jcangeles/ENGR301/README.md

# ENGR301  

SFSU - ENGR 301 Microelectronics Lab  

Final Project - Low Noise Headphone Amplifier  

See final report for documentation.  

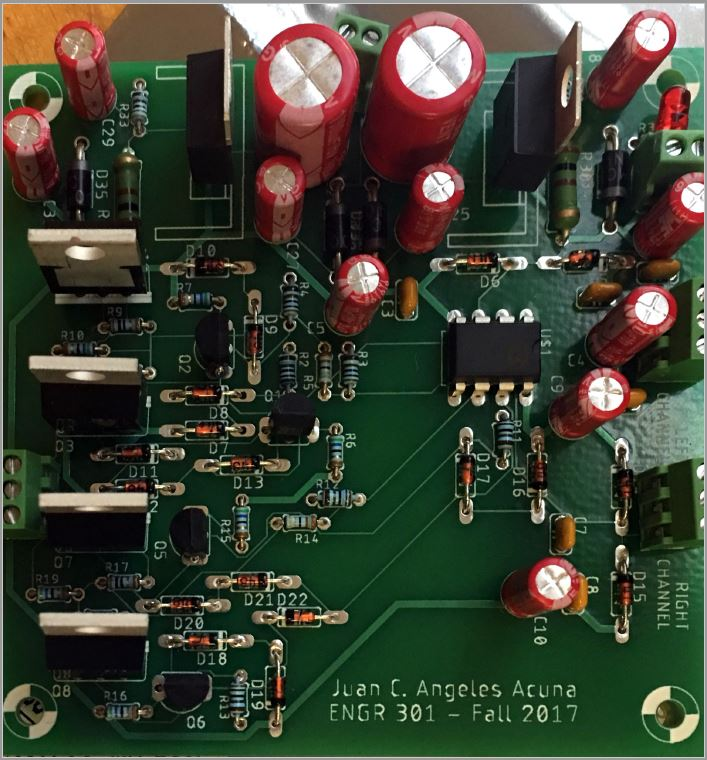
[picture p1: final board.JPG]
"Spirit Machine Wire Diagram"
