jcangeles/ENGR301/Final Report.pdf

Final Project Report

ENGR 301
Section 1
Fall, 2017

Juan C. Angeles Acuna
Jasmine Lai
12/10/17

Electrical Engineering
Engineering Department
San Francisco State University

Objective:
This report details the building process of our Engr 301 final project, a low-noise headphone amplifier. The objective of the project was to familiarize students with the process of designing and building a circuit, its board, component assembly, and testing/debugging our board

Components List:
Students were challenged to minimize the total price of components purchased. We were able to price the total price per board below ~$30 by buying in bulk as a group. Our Bill of Materials is listed in Appendix A at the end of this report.

Design:
Amplifier: A low-noise amplifier or LNA is an electronic amplifier that amplifies a very low-power signal without significantly degrading its signal-to-noise ration and minimize any additional noise. Our design for the amplifier (show below) is composed of four primary parts.

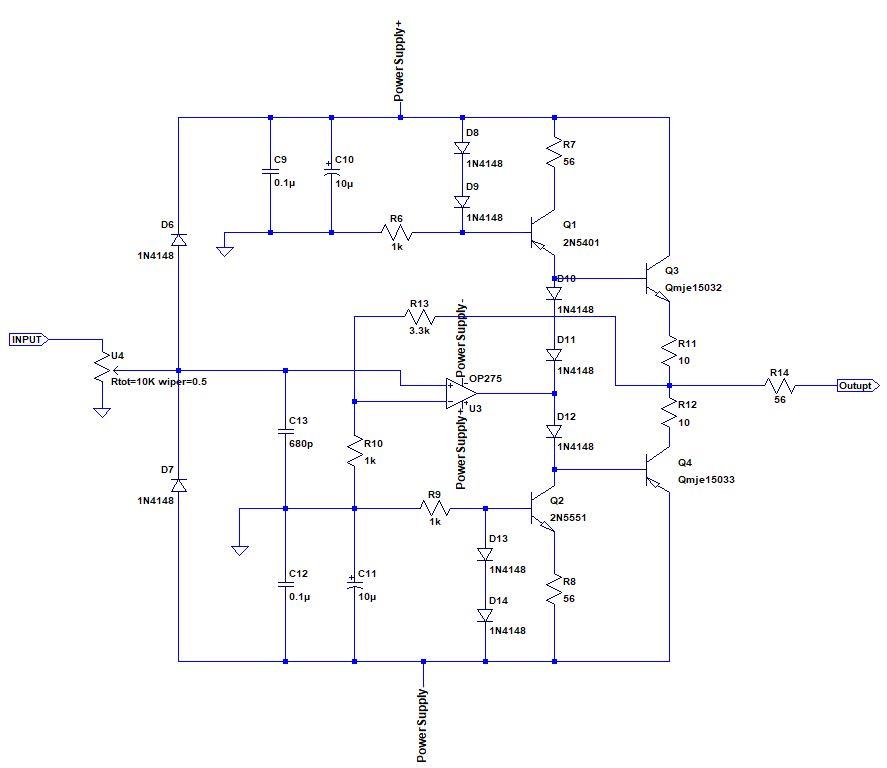
[picture p2: figure]

Amplifier simulation recreated in LTSpice

### 1. Non-Inverting Amplifier (OP275)

In the amplifier design, the non-inverting amplifier played a major role in keeping the distortion rate in the low range. It is known to be a highly valued op amp that can generally output linearly waveforms. Since non-inverting amplifiers are very sensitive compared to other op amps, they
would be able to reproduce the most accurate waveforms. More importantly, it combines both

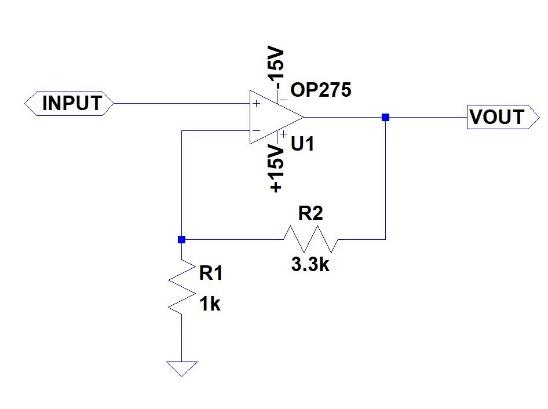
[picture p3: figure]

bipolar and other transistors to help maintain the speed and sound quality, making it the perfect op amp to use for the amplifier design

### 2. Voltage Divider (Potentiometer)

The voltage divider is a common engineering tool generally used in a variety of industries. Used as a voltage divider for various circuits, it’s main structure consists of three terminals total, where two of these terminals are connected to the ends of a resistive component. This type of resistive component is usually regarded as two resistors connected in series whereas the wiper determines the resistance ratio of the first resistor to the second resistor. Most importantly, it provides a changeable voltage as a control level in the amplifier circuit design in the final project.

### 3. Output Voltage Swing (Transistors)

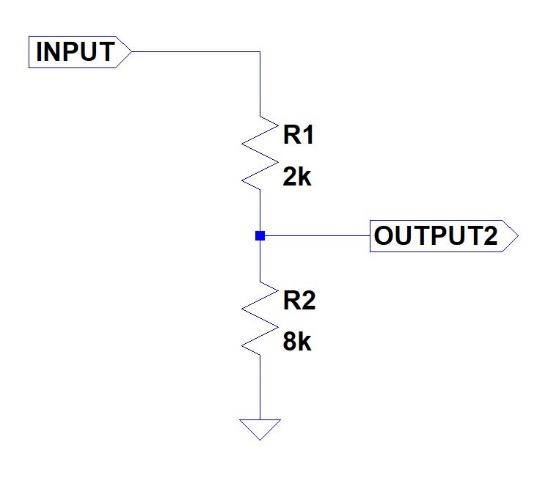
[picture p4: figure]

The output voltage swings are a set of transistors, which are defined as how close the op-amp output is under specified conditions. The main goal of these transistors is to determine the amount of current of the op-amp and its capability of the op-amp is largely dependent on the op-amp’s output along with the load current. The transistors played a critical role to the amplifier circuit design as they tell you whether the circuit works as planned.

### 4. Filter Capacitors

The filter capacitors play a role of filtering out a certain range of different frequencies in a circuit board. Acting as a low-pass filter, these capacitors are in charge of passing through low frequency signals and blocking the high frequency signals. Their purpose is not to filter noise that’s coming in, but to prevent any device from injecting noise into the main section.

Power supply: Our power supply is composed of a rectifier circuit that acts as a AC to DC converter, and we regulate the output voltage to +15 and -15V. The PSU, pictured below, is composed of 4 main sections.

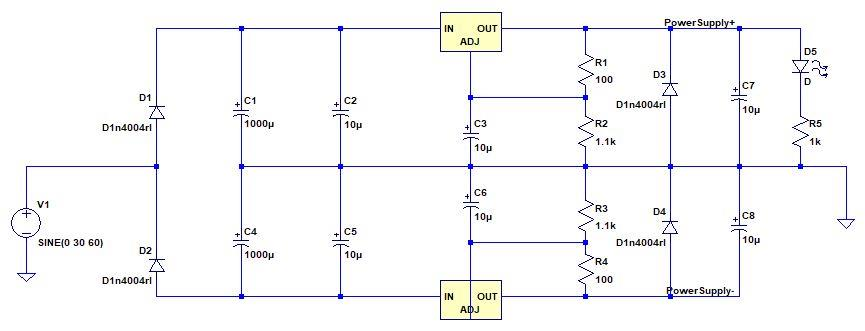
[picture p5: figure]

PSU in LTSpice Simulation

### 1. Rectifier (Diode)

In the power supply design, the rectifier is an electrical device that converts alternating current(AC) to direct current(DC). It is composed of one or more diodes and it can take the shape of various forms. Most importantly, the rectifier can be performed in a variety of such as a source of power used in laptops, televisions, and video games. Based on the power supply design, we needed a rectifier
to get DC current to operate the circuit.

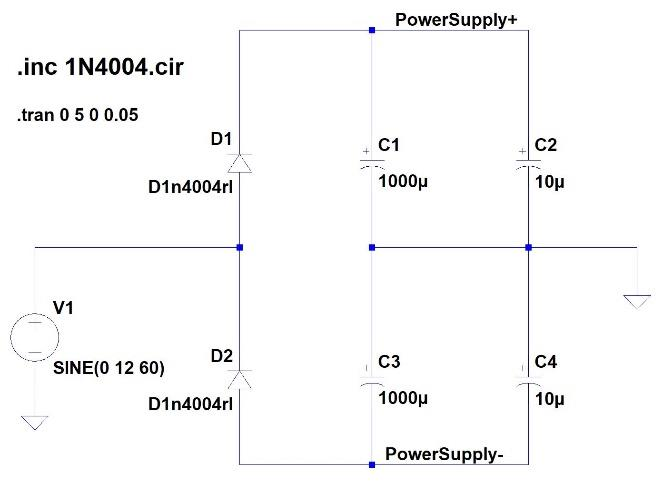
[picture p6: figure]

### 2. Positive and Negative Voltage Regulators (±15V)

The voltage regulators on the power supply design serves to generate a fixed output voltage of a preset magnitude that remains constant regardless of the changes to the input voltage. This regulation of the output voltage level is usually handled by various feedback techniques such as the Zener diode for example. For the power supply design, we used both positive and negative voltage regulators to operate the circuit.

### 3. Bypass Capacitors

The bypass capacitors are in charge of shorting out the AC signals to ground so that any of the AC noise is removed. So basically, this capacitor type will bypass all the AC noise lingering on a DC signal and filter it out to make sure that there’s AC ripple going through the DC signal. These AC ripples are most likely going to show up, especially at very high frequencies. We wanted to make the DC signal stay as clean as possible and we don’t want any AC ripples, so we used some of these bypass capacitors in our circuit.

### 4. Terminal Blocks (Usage)

The terminal blocks serve as a connector, which basically allows more than one circuit to connect to another circuit. Known as connection terminals, they are used to secure and terminate wires. Most people use these terminal blocks for connecting the wires to ground and connecting the electrical switches and outlets to the main section. Their main purpose is to reduces corrosion caused by the action between two different types of metals.

Using Eagle
Using Eagle, we reconstructed the schematics given to us (in pdf) during the first weeks in class for both the PSU and left/right amplifiers, all in one sheet. We were provided the additional components that were not in Eagle’s standard library. We placed each component, picking out the ones of the smallest size due to our board-size constraint of 3x3in. With in a couple of weeks, we came up the following:

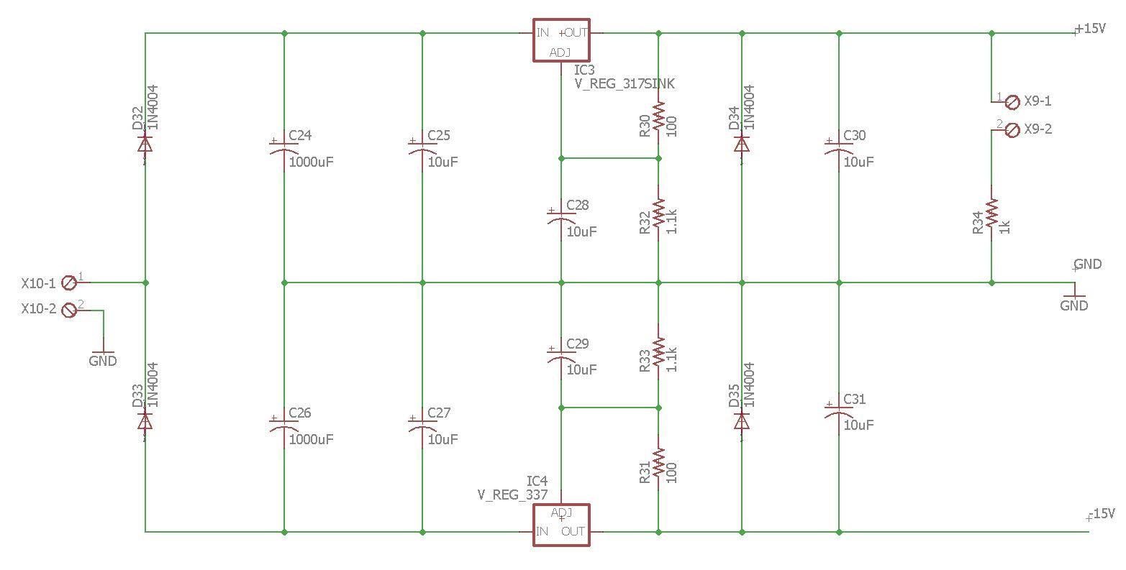
[picture p7: figure]

Power Supply Schematic in EAGLE

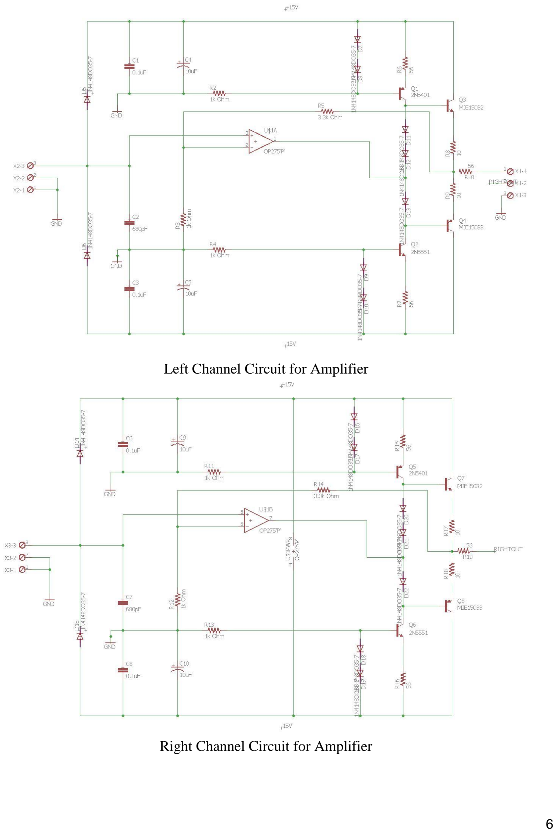
[picture p8: page 6]

Left Channel Circuit for Amplifier

Right Channel Circuit for Amplifier

When we finished placing all the necessary components on our schematics, including the connectors to the components that are not in the board, our next step is to design the board itself. From EAGLE itself, we generated a 3x3in board and placed the components one by one. In the figure below, we see the placement of all the components in addition to some notes:
- We tried to placement as to no have any vias and most importantly, have a clean trace to reduce noise generated by other parts of the circuit.
- To the left, we see the components of the PSU, while on the right we have the power lines going from top to bottom across the amplifiers.
- In addition, we labeled the left/right channel input (top) and output (bottom)and placed our name, class, and semester.
- We placed a board-wide ground pour.
- We placed mounting holes on each corner to mount on an enclosure.
- We made our power lines wider.

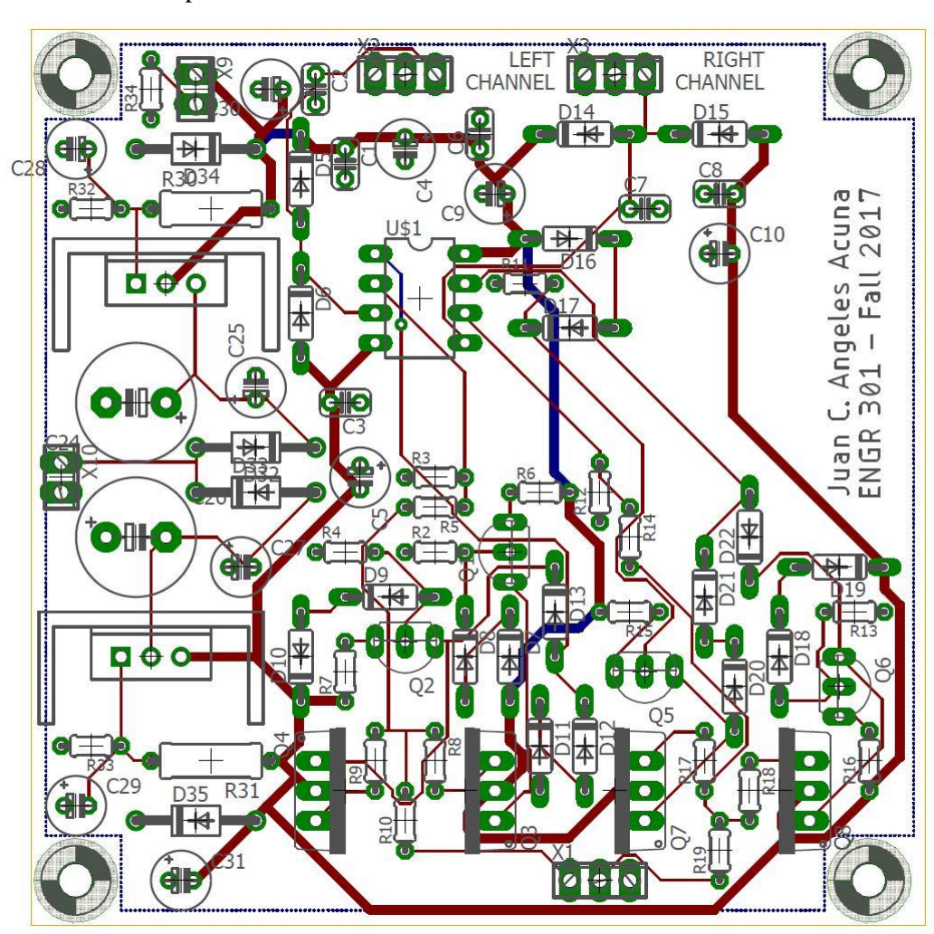
[picture p9: figure]

EAGLE generated board

Once all the components were placed, we were confident our build was successful (no errors in all the tests provided in EAGLE), they were ready to be shipped to the PCB manufacturer. From EAGLE CAM, we generated GERBER files (which consisted of Component side, solder side, silk screen CMP, solder stop mask CMP, and solder stop mask SOL, etc), which are the files needed to build the board.

Purchasing
While waiting for the manufacturer, students oversaw purchasing the components (listed in Appendix A). We got all our stuff from Digikey, and purchased in bulk for two people. The specs for each part were obtained from EAGLE schematics. For every component, we needed the specific value and size as we needed to fit them all in one board.

Soldering/Building
Soldering was a relatively easy process, having experience in the field and the ability to learn fast. Our group finished soldered with little to now problem. We started with smaller components, such as resistors and caps, and worked our way up in terms of size.

Conclusion
This semester-long project gave us key knowledge on the process of designing and building a circuit board. Through EAGLE, we learn how to design and build a schematic, generate an efficient board layout, and GERBER files. We also learned how to choose and shop for electronic components, within a given set of constraints, size and money. Finally, we learned the process of soldering, desoldering, testing and debugging our built board. As of the time this writing, one of our fully built board work flawlessly, and we expect the other to do as well. All this gain knowledge will be crucial for our senior project, and our future jobs. As a side note, in the process of writing this report to created simulations which were not required but are shown in the figures throughout the report. (see picture below)

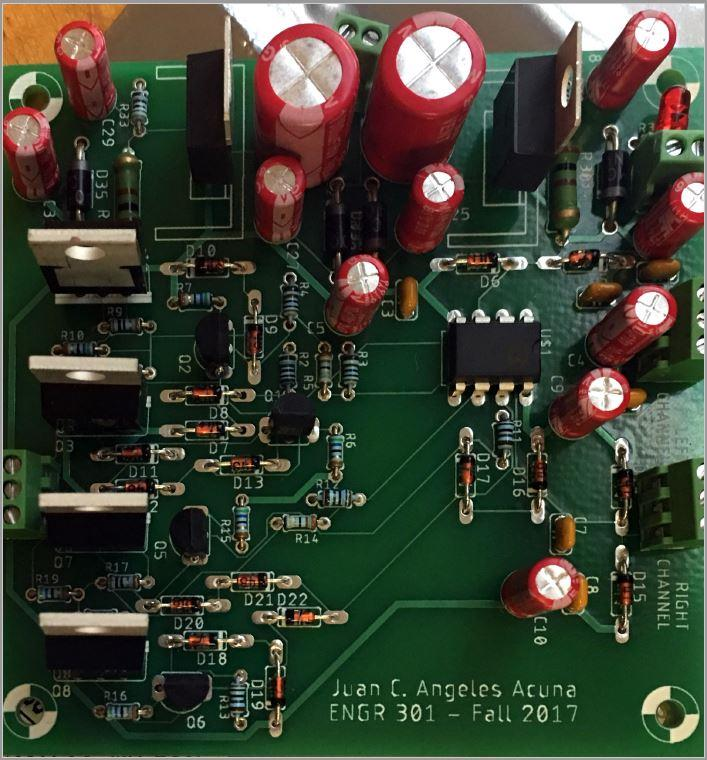
[picture p10: figure]

Final board (working w/ extra credit) =)

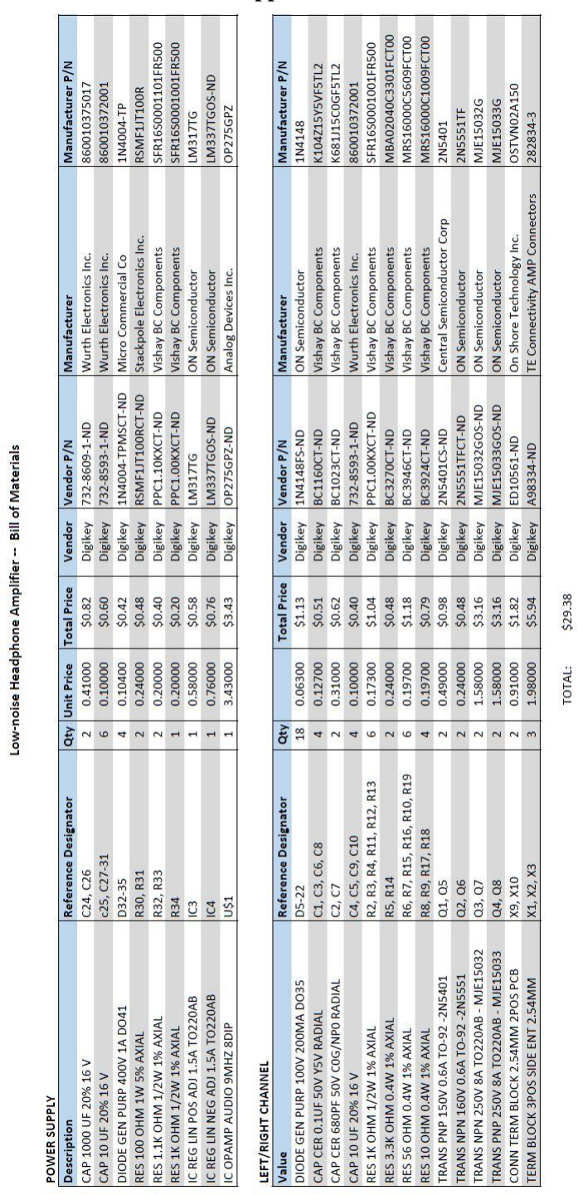
[picture p11: figure]

Appendix A
