jcangeles/ENGR301/jangeles.brd

## EAGLE design jangeles.brd (2019-01-30)

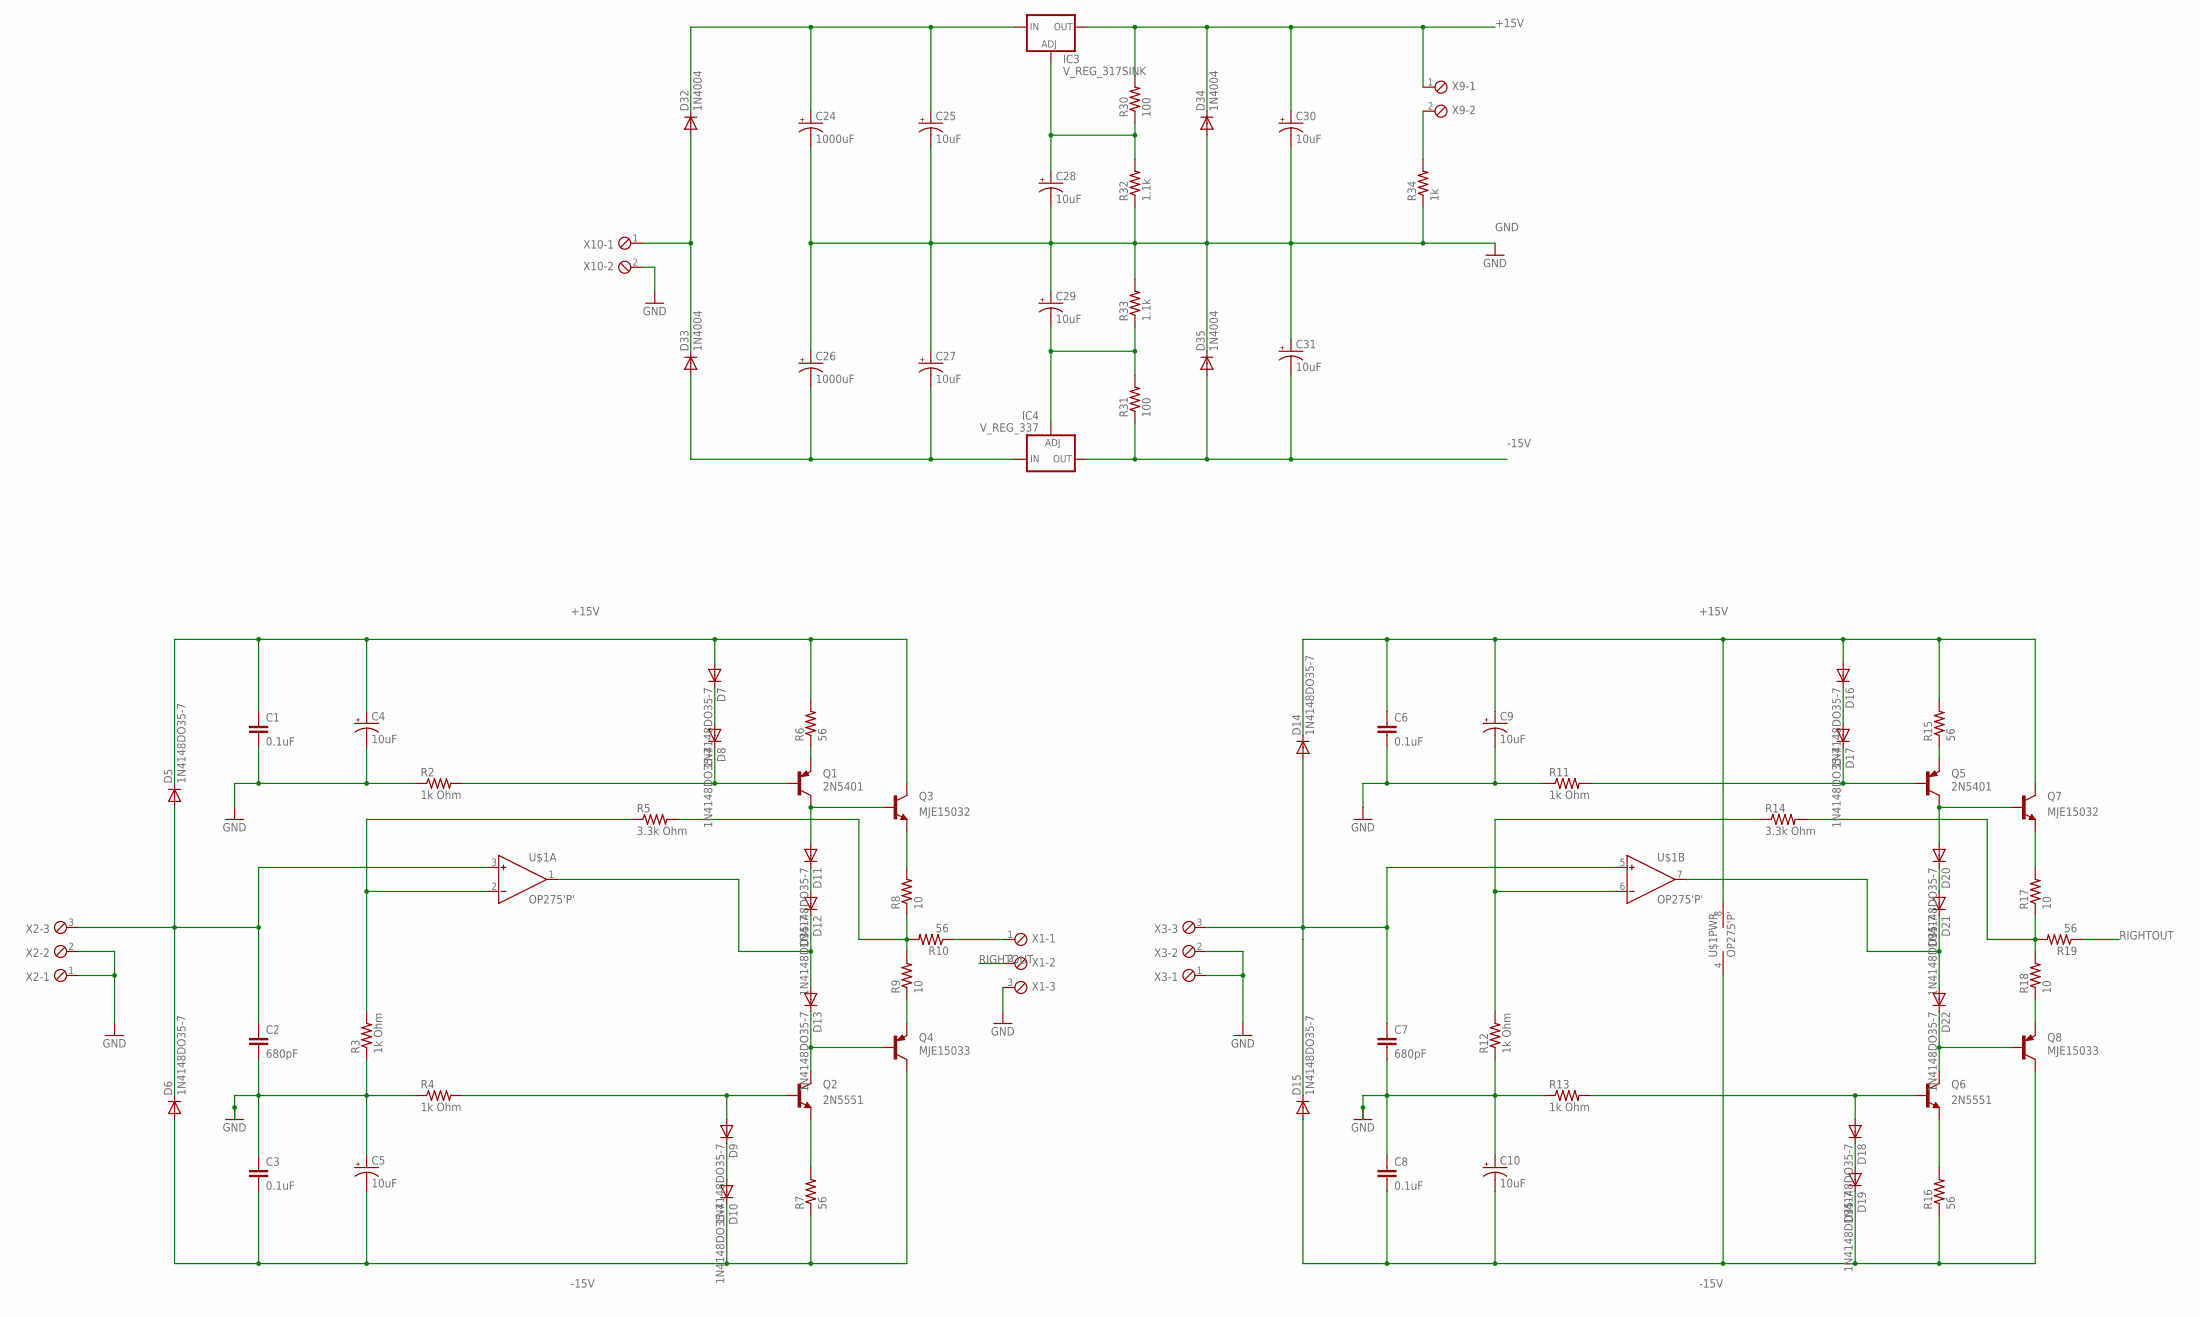
[picture p12: schematic jangeles.sch, LEFT CHANNEL]

Parts:
C1, C3, C6, C8: 0.1uF; C025-024X044
C2, C7: 680pF; C025-024X044
C4, C5, C9, C10, C25, C27, C28, C29, C30, C31: 10uF; E2-5
C24, C26: 1000uF; E5-10,5
D5, D6, D7, D8, D9, D10, D11, D12, D13, D14, D15, D16, D17, D18, D19, D20, D21, D22: 1N4148DO35-7; DO35-7
D32, D33, D34, D35: 1N4004; DO41-10
IC3: V_REG_317SINK; TO220-ADJ
IC4: V_REG_337; TO220-ADJ-NEG
Q1, Q5: 2N5401
Q2, Q6: 2N5551
Q3, Q7: MJE15032; TO220V
Q4, Q8: MJE15033; TO220V
R2, R3, R4, R11, R12, R13: 1k Ohm; 0204/5
R5, R14: 3.3k Ohm; 0204/5
R6, R7, R10, R15, R16, R19: 56; 0204/5
R8, R9, R17, R18: 10; 0204/5
R30, R31: 100; 0309/10
R32, R33: 1.1k; 0204/5
R34: 1k; 0204/5
U$1: OP275'P'; DIL08
X1, X2, X3: MPT3; 3POL254
X9, X10: MPT2; 2POL254

Connections:
+15V: C1.1, C4.+, C6.1, C9.+, C30.+, D5.C, D7.A, D14.C, D16.A, D34.C, IC3.OUT, Q3.2 (C), Q7.2 (C), R6.2, R15.2, R30.2, U$1.8 (V+), X9.1
-15V: C3.2, C5.-, C8.2, C10.-, C31.-, D6.A, D10.C, D15.A, D19.C, D35.A, IC4.OUT, Q4.2 (C), Q8.2 (C), R7.1, R16.1, R31.1, U$1.4 (V-)
GND: C1.2, C2.2, C3.1, C4.-, C5.+, C6.2, C7.2, C8.1, C9.-, C10.+, C24.-, C25.-, C26.+, C27.+, C28.-, C29.+, C30.-, C31.+, D34.A, D35.C, R2.1, R3.1, R4.1, R11.1, R12.1, R13.1, R32.1, R33.2, R34.1, X1.3, X2.1, X2.2, X3.1, X3.2, X10.2
unnamed: D7.C, D8.A
unnamed: D9.C, D10.A
unnamed: Q2.E, R7.2
unnamed: D9.A, Q2.B, R4.2
unnamed: R3.2, R5.1, U$1.2 (IN-)
unnamed: D18.C, D19.A
unnamed: Q3.3 (E), R8.2
unnamed: R5.2, R8.1, R9.2, R10.2
unnamed: Q4.3 (E), R9.1
unnamed: D13.C, Q2.C, Q4.1 (B)
unnamed: D12.C, D13.A, U$1.1 (OUT)
unnamed: D11.C, D12.A
unnamed: D11.A, Q1.C, Q3.1 (B)
unnamed: Q1.E, R6.1
unnamed: Q6.E, R16.2
unnamed: D18.A, Q6.B, R13.2
unnamed: D8.C, Q1.B, R2.2
unnamed: Q7.3 (E), R17.2
unnamed: R14.2, R17.1, R18.2, R19.2
unnamed: Q8.3 (E), R18.1
unnamed: D22.C, Q6.C, Q8.1 (B)
unnamed: D21.C, D22.A, U$1.7 (OUT)
unnamed: D20.C, D21.A
unnamed: D20.A, Q5.C, Q7.1 (B)
unnamed: Q5.E, R15.1
unnamed: D17.C, Q5.B, R11.2
unnamed: R12.2, R14.1, U$1.6 (IN-)
unnamed: D16.C, D17.A
unnamed: R10.1, X1.1
unnamed: D32.A, D33.C, X10.1
unnamed: C26.-, C27.-, D33.A, IC4.IN
unnamed: C24.+, C25.+, D32.C, IC3.IN
unnamed: C29.-, IC4.ADJ, R31.2, R33.1
unnamed: C28.+, IC3.ADJ, R30.1, R32.2
unnamed: R34.2, X9.2
R2: C7.1, D14.A, D15.C, U$1.5 (IN+), X3.3
R5: C2.1, D5.A, D6.C, U$1.3 (IN+), X2.3
RIGHTOUT: R19.1, X1.2

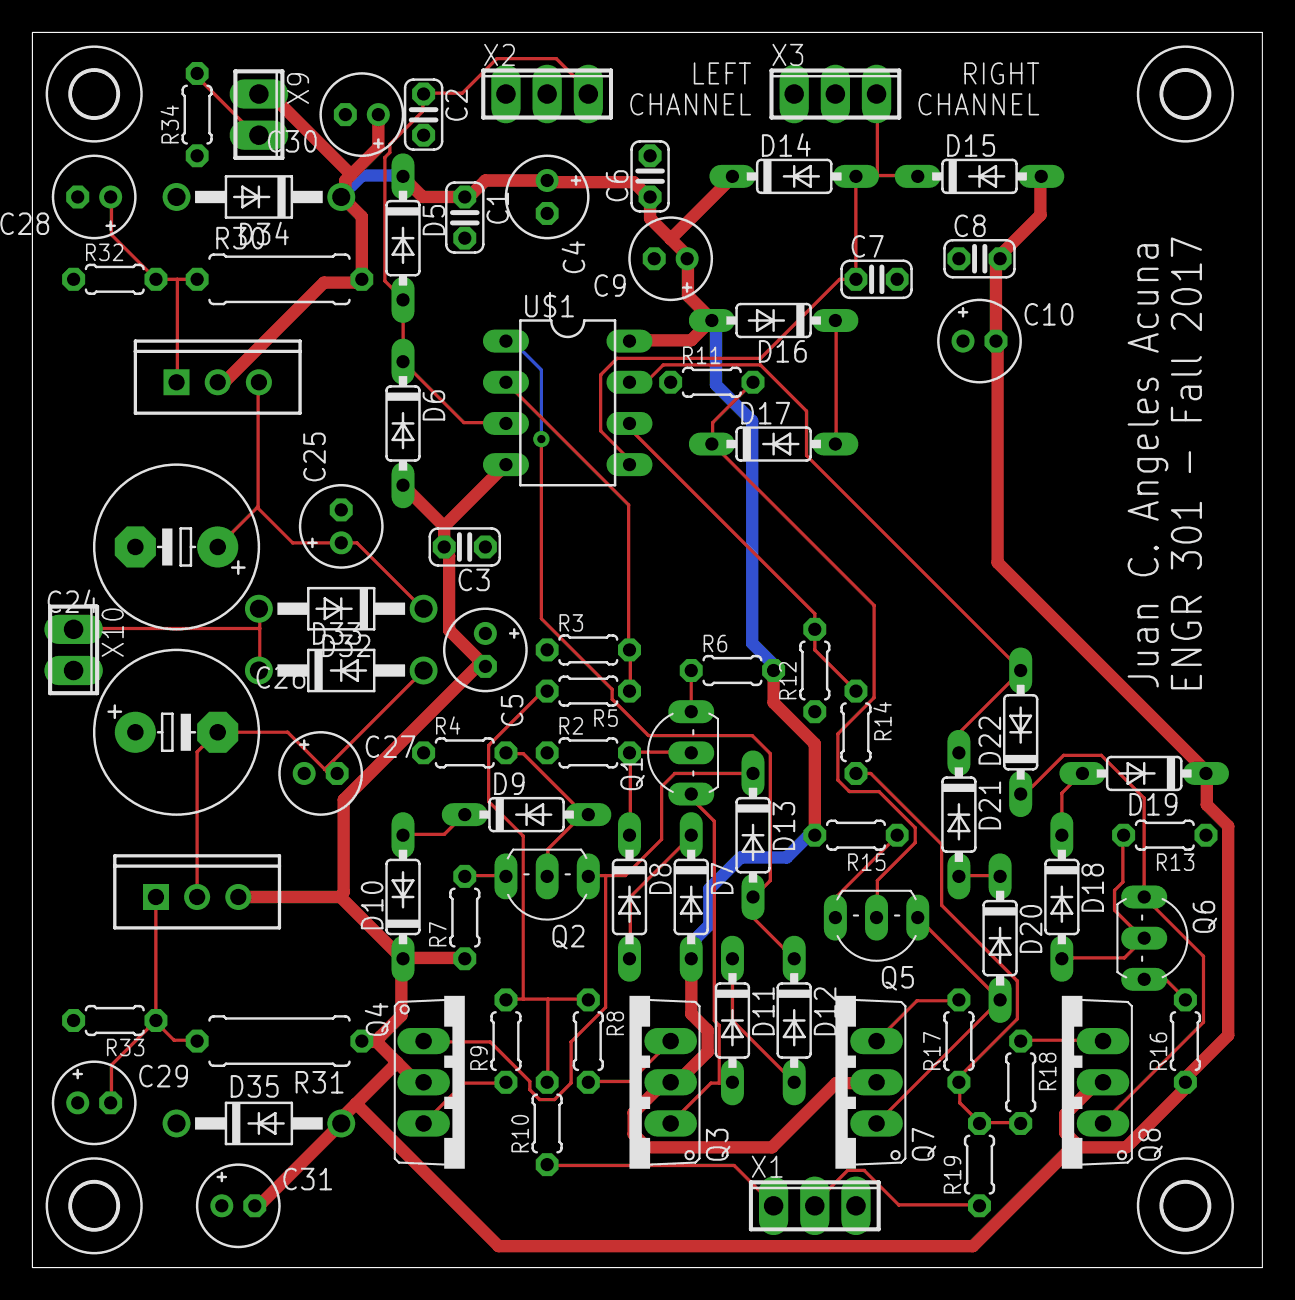
[picture p13: board jangeles.brd from above]

Board: 2 copper layers, 75.9 x 76.2 mm, 83 parts (0 on the bottom side), 41 nets.

Other parts of the board:
U$2, U$3, U$4, U$5: 2,8
